watsonboyett/ReflowOvenController/README.md

ThermoBot
====================

A temperature controller module that's designed to follow a pre-programmed temperature profile. The target application for this project is to be used a controller for a reflow oven.
