watsonboyett/ReflowOvenController/hardware/archive/ThermoBot v1B - Schematic.pdf

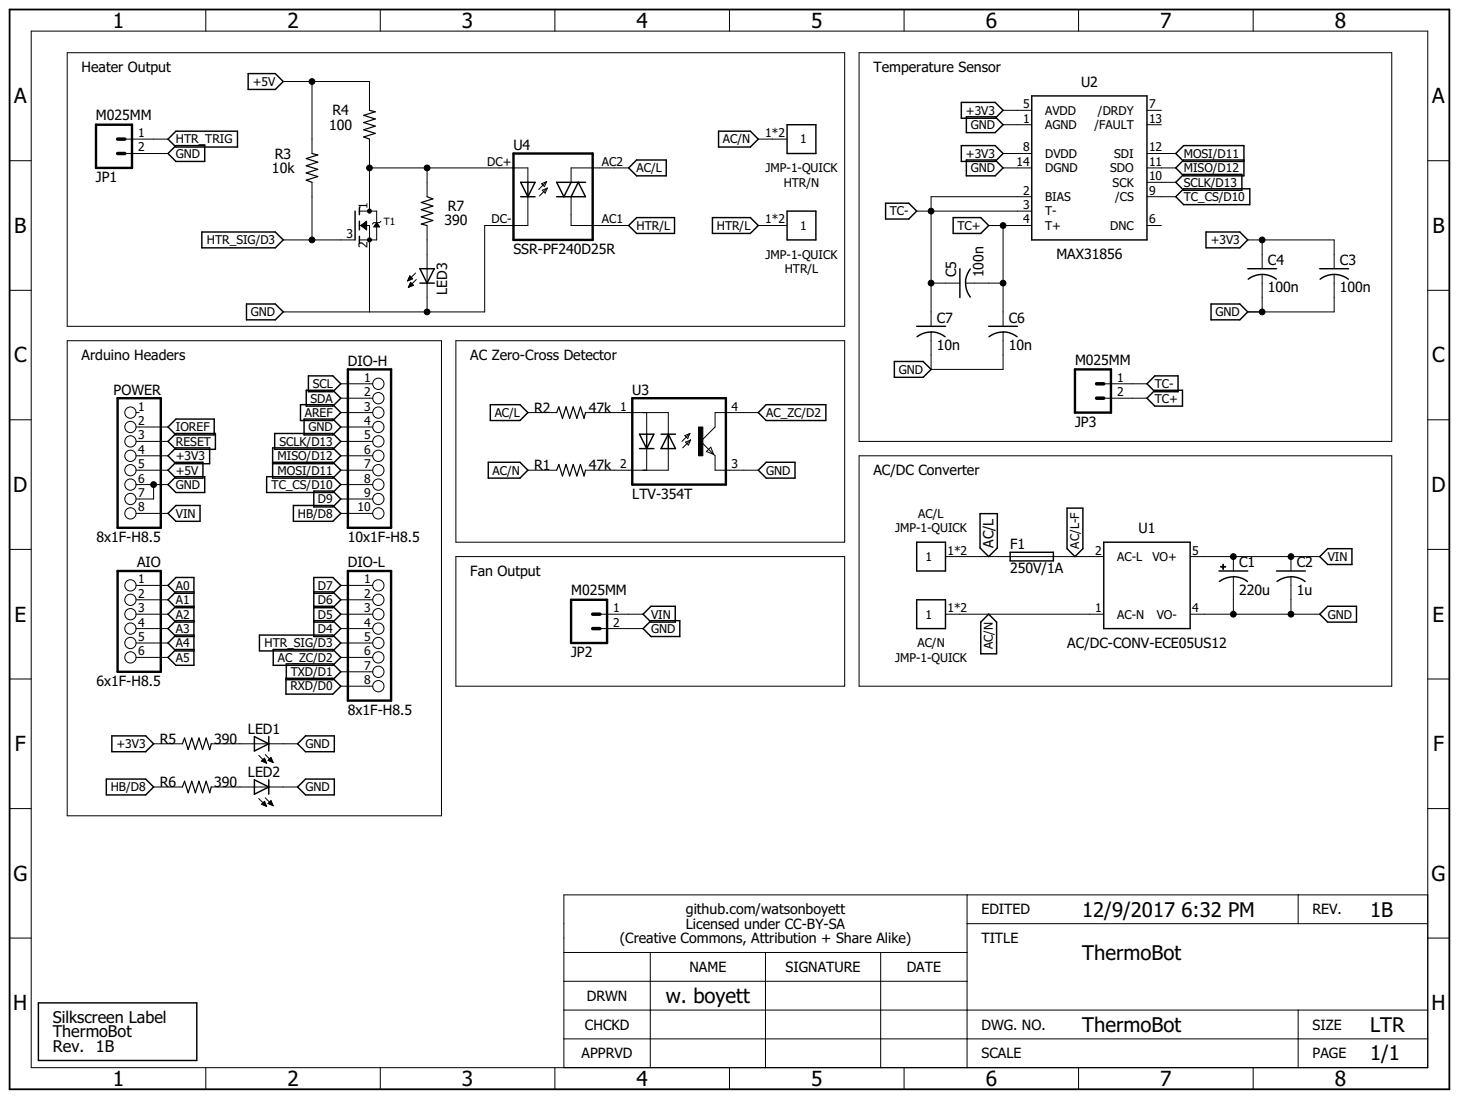
[picture p1: page 1]

AC Zero-Cross Detector

github.com/watsonboyett
Licensed under CC-BY-SA

(Creative Commons, Attribution + Share Alike)

NAME | SIGNATURE | DATE

DRWN | w. boyett
CHCKD | | | | ThermoBot | SIZE LTR

APPRVD | | | | SCALE | PAGE 1/1
