watsonboyett/ReflowOvenController/hardware/archive/ThermoBot v1B - Values.pdf

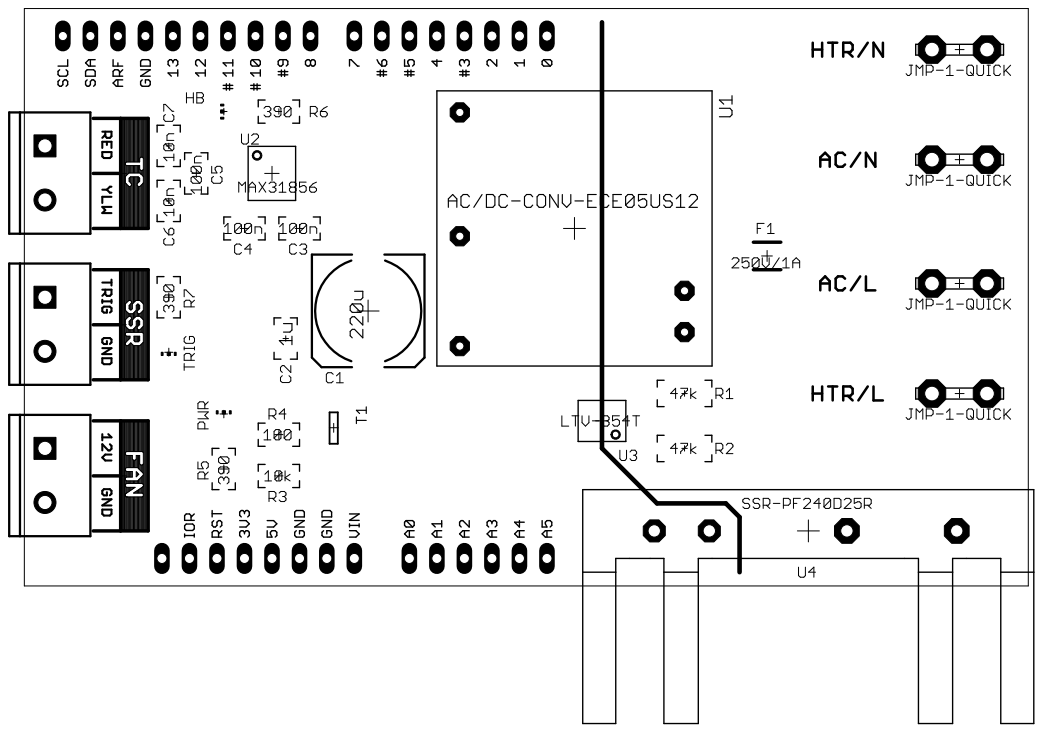
[picture p2: page 1]
