watsonboyett/ReflowOvenController/hardware/archive/ThermoBot v1A - Schematic.pdf

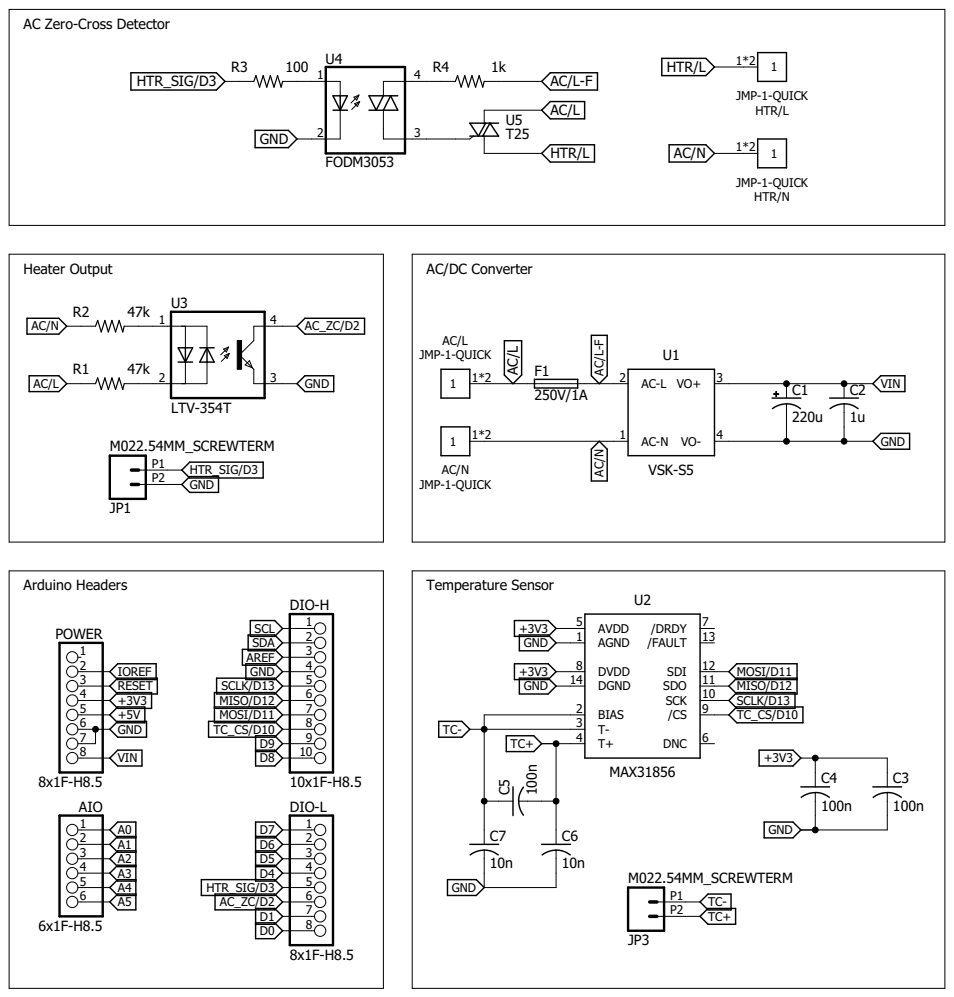
[picture p3: page 1]

AC Zero-Cross Detector
