watsonboyett/ReflowOvenController/hardware/ThermoBot.brd

## EAGLE design hardware/ThermoBot.brd (2017-12-19)

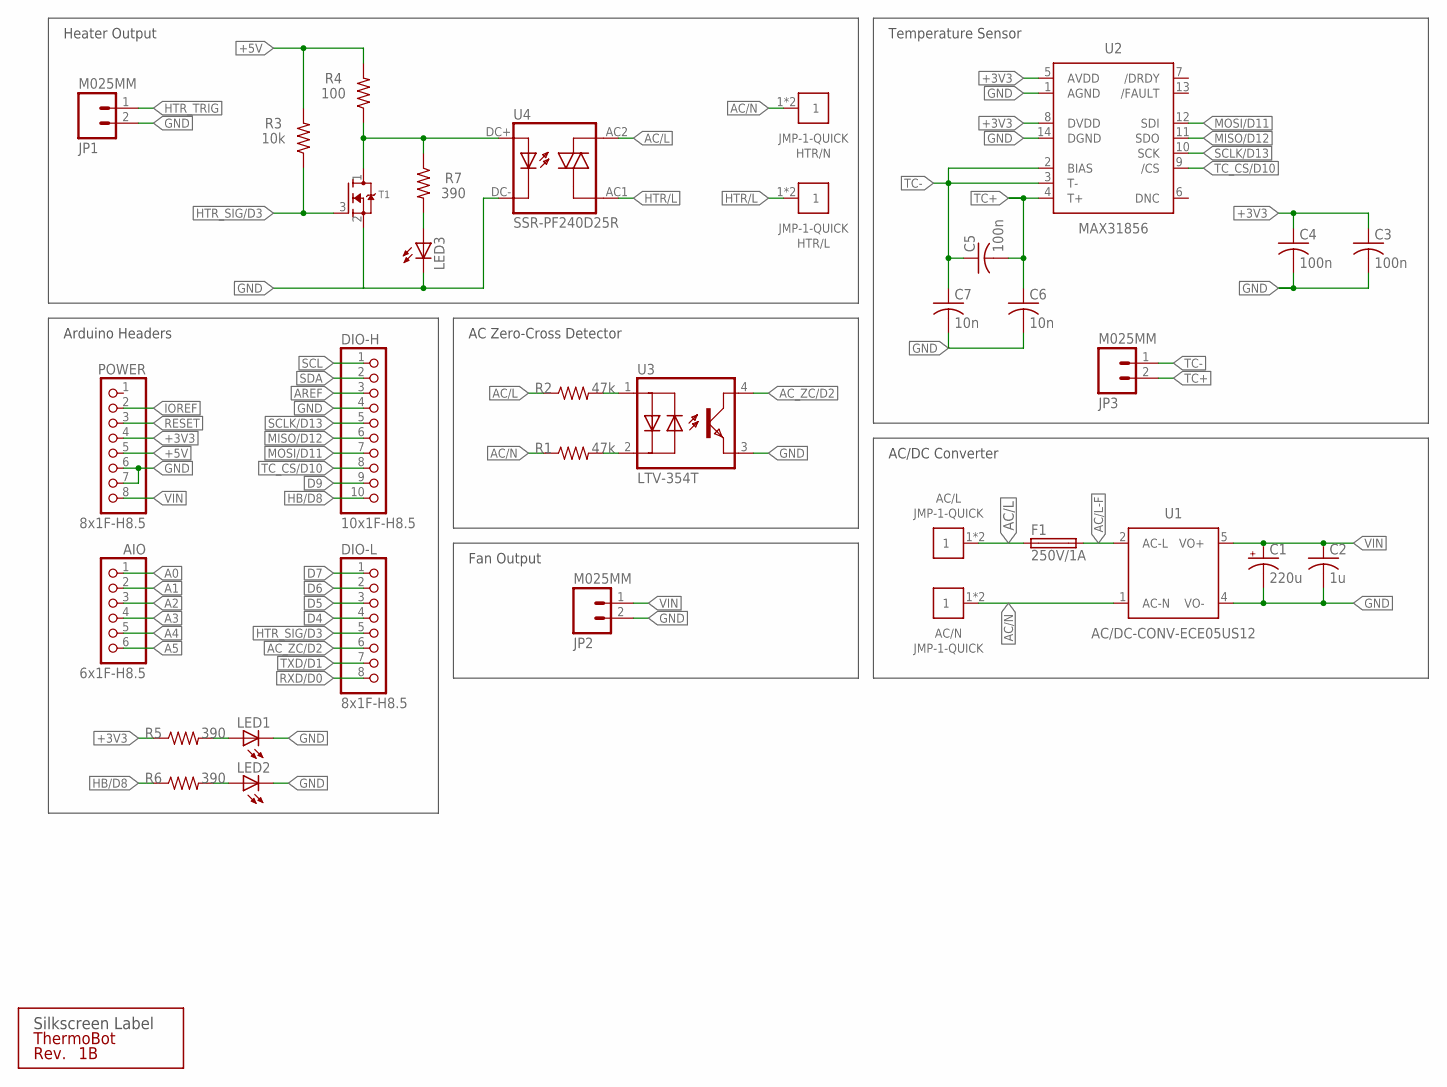
[picture p4: schematic ThermoBot.sch]

Parts:
AC/L: JMP-1-QUICK; QUICK-1
AC/N: JMP-1-QUICK; QUICK-1
AIO: 6x1F-H8.5; 1X06
C1: 220u; 153CLV-1014
C2: 1u; C0805
C3, C4, C5: 100n; C0805
C6, C7: 10n; C0805
DIO-H: 10x1F-H8.5; 1X10
DIO-L: 8x1F-H8.5; 1X08
F1: 250V/1A; 2SMD-2410; MPN 0454001.MR
HTR/L: JMP-1-QUICK; QUICK-1
HTR/N: JMP-1-QUICK; QUICK-1
JP1, JP2, JP3: M025MM; SCREWTERMINAL-5MM-2
LED1, LED2, LED3: LEDCHIP-LED0805; CHIP-LED0805
POWER: 8x1F-H8.5; 1X08
R1, R2: 47k; R1206
R3: 10k; R0805
R4: 100; R0805
R5, R6, R7: 390; R0805
T1: MOSFET-N-SOT23; SOT-23
U1: AC/DC-CONV-ECE05US12; ECE05
U2: MAX31856; TSSOP14
U3: LTV-354T; SOP-4
U4: SSR-PF240D25R; SIP-4
U$1: SILK_QC

Connections:
+3V3: C3.1, C4.1, POWER.4, R5.1, U2.5 (AVDD), U2.8 (DVDD)
+5V: POWER.5, R3.2, R4.2
A0: AIO.1
A1: AIO.2
A2: AIO.3
A3: AIO.4
A4: AIO.5
A5: AIO.6
AC/L: AC/L.1, AC/L.2, F1.P$1 (1), R2.1, U4.AC2 (A2)
AC/L-F: F1.P$2 (2), U1.2 (AC-L)
AC/N: AC/N.1, AC/N.2, HTR/N.1, HTR/N.2, R1.1, U1.1 (AC-N)
AC_ZC/D2: DIO-L.6, U3.4 (COL)
AREF: DIO-H.3
D4: DIO-L.4
D5: DIO-L.3
D6: DIO-L.2
D7: DIO-L.1
D9: DIO-H.9
GND: C1.-, C2.2, C3.2, C4.2, C6.2, C7.2, DIO-H.4, JP1.2, JP2.2, LED1.C, LED2.C, LED3.C, POWER.6, POWER.7, T1.2 (S1), U1.4 (VO-), U2.1 (AGND), U2.14 (DGND), U3.3 (EMIT), U4.DC- (C)
HB/D8: DIO-H.10, R6.1
HTR/L: HTR/L.1, HTR/L.2, U4.AC1 (A1)
HTR_SIG/D3: DIO-L.5, R3.1, T1.3 (G1)
HTR_TRIG: JP1.1, R4.1, R7.1, T1.1 (D1), U4.DC+ (A)
IOREF: POWER.2
MISO/D12: DIO-H.6, U2.11 (SDO)
MOSI/D11: DIO-H.7, U2.12 (SDI)
unnamed: R1.2, U3.2 (C)
unnamed: R2.2, U3.1 (A)
unnamed: LED3.A, R7.2
unnamed: LED1.A, R5.2
unnamed: LED2.A, R6.2
RESET: POWER.3
RXD/D0: DIO-L.8
SCL: DIO-H.1
SCLK/D13: DIO-H.5, U2.10 (SCK)
SDA: DIO-H.2
TC+: C5.2, C6.1, JP3.2, U2.4 (T+)
TC-: C5.1, C7.1, JP3.1, U2.2 (BIAS), U2.3 (T-)
TC_CS/D10: DIO-H.8, U2.9 (/CS)
TXD/D1: DIO-L.7
VIN: C1.+, C2.1, JP2.1, POWER.8, U1.5 (VO+)

Notes on the sheet:
Arduino Headers
Temperature Sensor
Heater Output
AC/DC Converter
AC Zero-Cross Detector
Fan Output

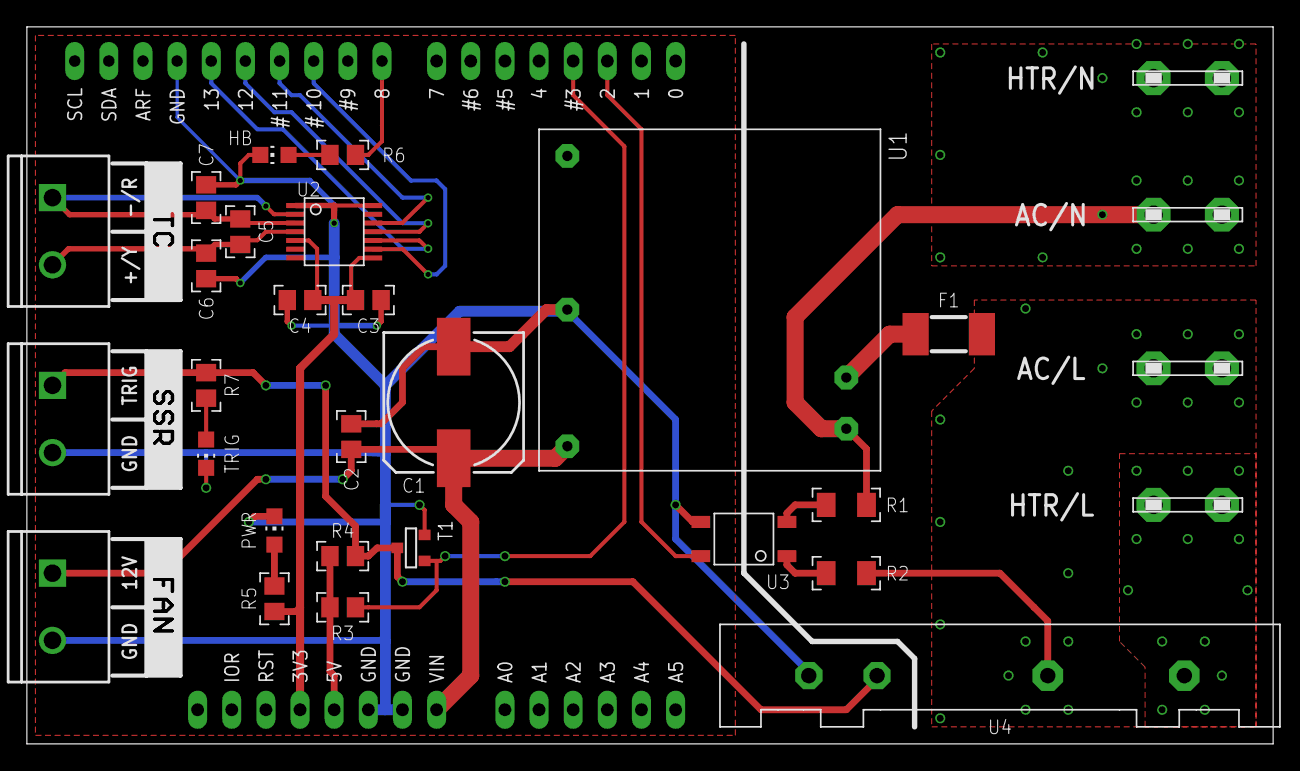
[picture p5: board ThermoBot.brd from above]

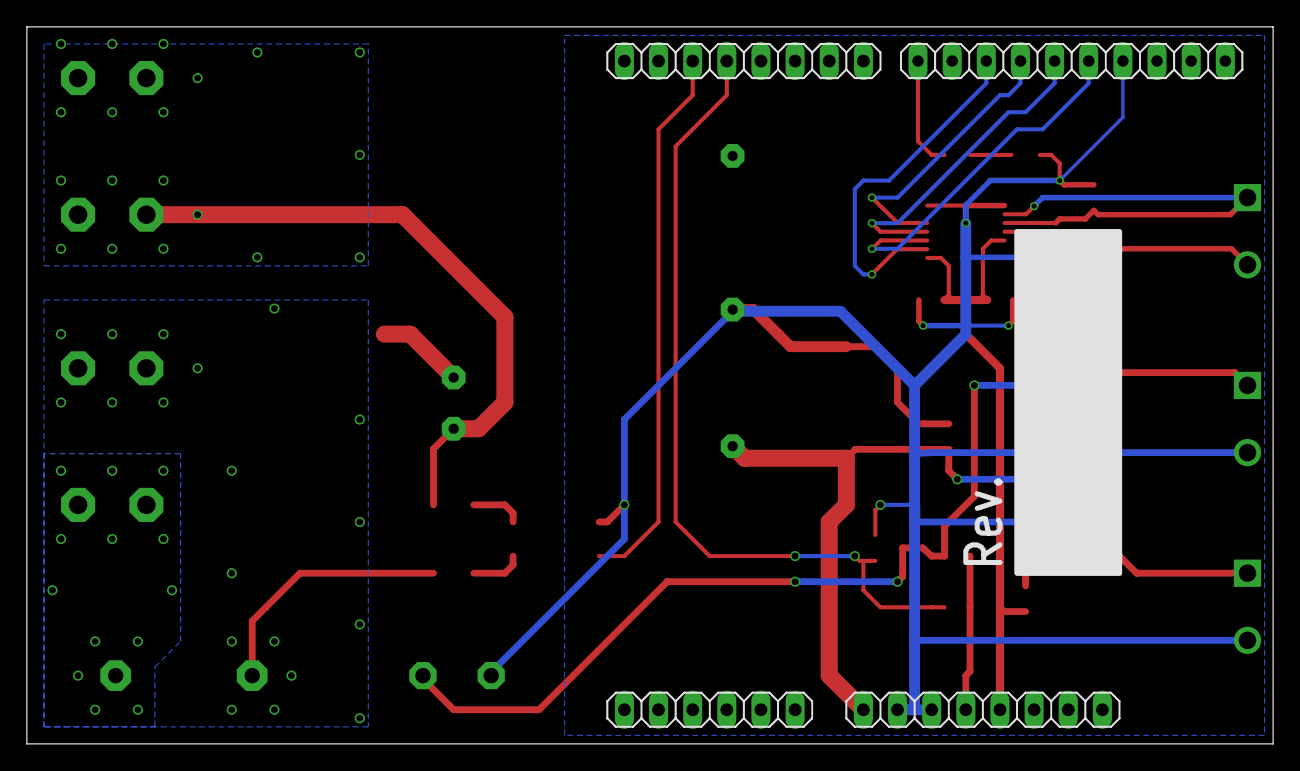
[picture p6: board ThermoBot.brd from below]

Board: 2 copper layers, 92.7 x 53.3 mm, 38 parts (5 on the bottom side), 23 nets.

Other parts of the board:
U$2: SILK_FAN
U$3: SILK_SSR
U$4: SILK_TC
