watsonboyett/ReflowOvenController/(commit log)

2017-06-10 Initial commit of existing project.
    [ReflowOvenController v1A - BOM.csv, ReflowOvenController.brd, ReflowOvenController.sch]
2017-06-10 Removed spurious BOM file
    [ReflowOvenController v1A - BOM.csv]
2017-06-10 Fixed BOM parts that used Digi-Reel packaging instead of cut-tape
    [ReflowOvenController v1A - BOM.csv]
2017-07-10 Improved mechanical layout. Added status leds.
    [ReflowOvenController.brd, ReflowOvenController.sch]
2017-07-10 Packed all parts into local project library. Renamed project files.
    [Tempatroller.brd, Tempatroller.sch]
2017-12-08 Renamed to ThermoBot
    [ThermoBot v1A - BOM.csv, ThermoBot.brd, ThermoBot.sch]
2017-12-08 Refactored code into separate modules. Added support for temperature setpoint profiles.
2017-12-09 Started hardware revisions for v1B
    [ThermoBot.brd, ThermoBot.sch]
2017-12-10 Finalized v1B design and generated MFG docs
    [ThermoBot v1B - BOM.csv, ThermoBot.brd, ThermoBot.sch]
2017-12-19 Updated TC silkscreen labels. Fixed via silkscreen mask. Regenerated archive file.
    [ThermoBot.brd]
