watsonboyett/ReflowOvenController/(notices)

Notices in the files:
hardware/ThermoBot.sch:
CONTACT_ADDRESS: Licensed under CC-BY-SA
CONTACT_PHONE: (Creative Commons, Attribution + Share Alike)
